janzavrel/Tensegrity_Based_Joionts/README.md

# Tensegrity_Based_Joionts
Stiffness Analysis of the Tensegrity Based Joints Compared to the Traditional Ones
