janzavrel/Tensegrity_Based_Joionts/03_winding_trajectory/models/tensegrity_revolute_joint_fixed_bottom_modif_AI.png

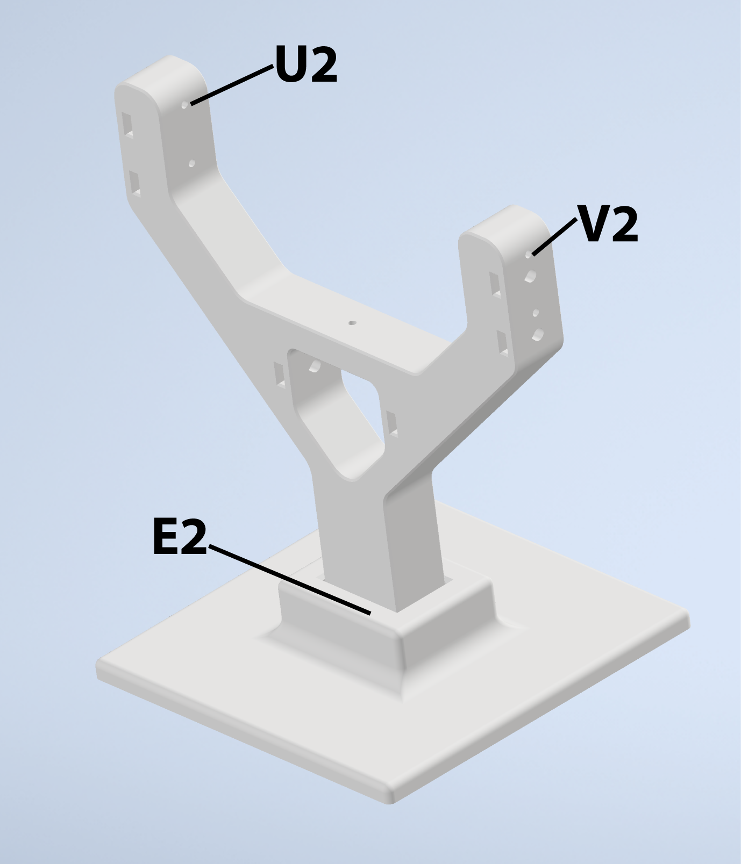
03_winding_trajectory/models/tensegrity_revolute_joint_fixed_bottom_modif_AI.png
