janzavrel/Tensegrity_Based_Joionts/03_winding_trajectory/models/tensegrity_revolute_joint_fixed_top_modif.png

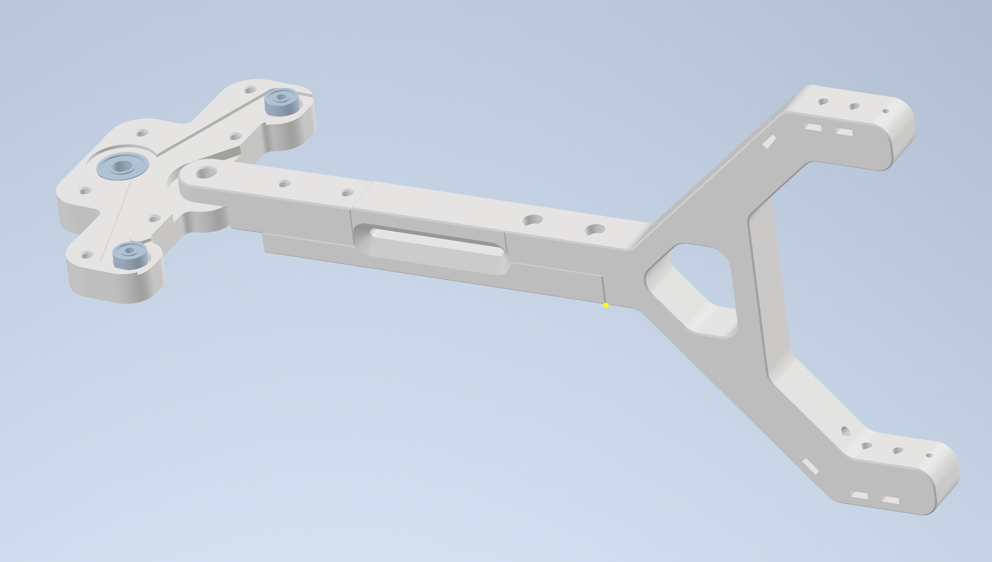
03_winding_trajectory/models/tensegrity_revolute_joint_fixed_top_modif.png
