janzavrel/Tensegrity_Based_Joionts/04_tensegrity_3D_Valasek_like/models/base_frame_3.png

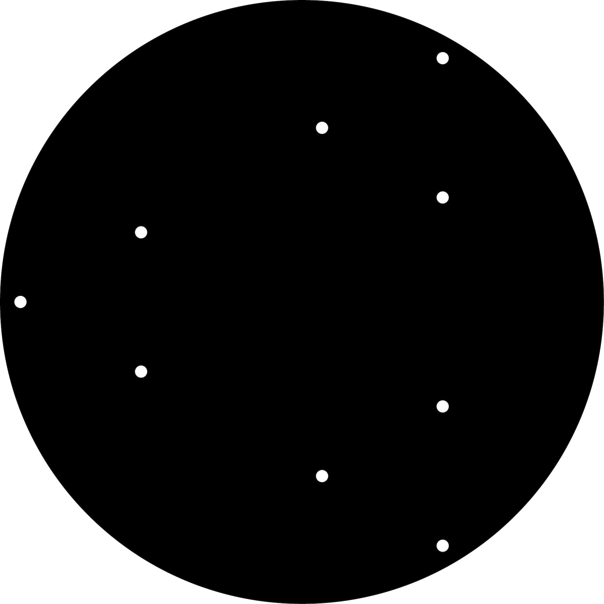
04_tensegrity_3D_Valasek_like/models/base_frame_3.png
