janzavrel/Tensegrity_Based_Joionts/05_tensegrity_joint_universal/Workspace_z_E3_x_y_z.png

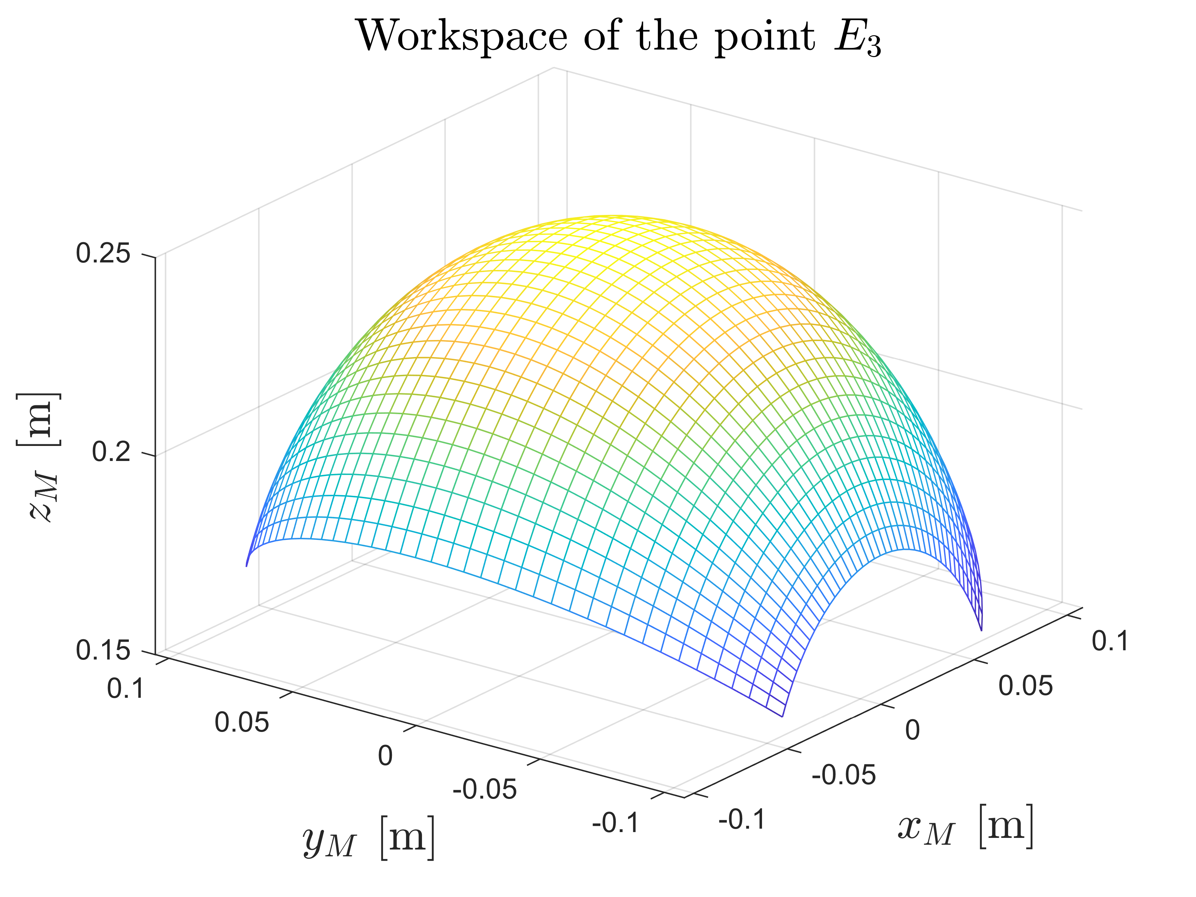
05_tensegrity_joint_universal/Workspace_z_E3_x_y_z.png
