janzavrel/Tensegrity_Based_Joionts/06_tensegrity_joint_revolute/revolute_joint_stiffnes_X.png

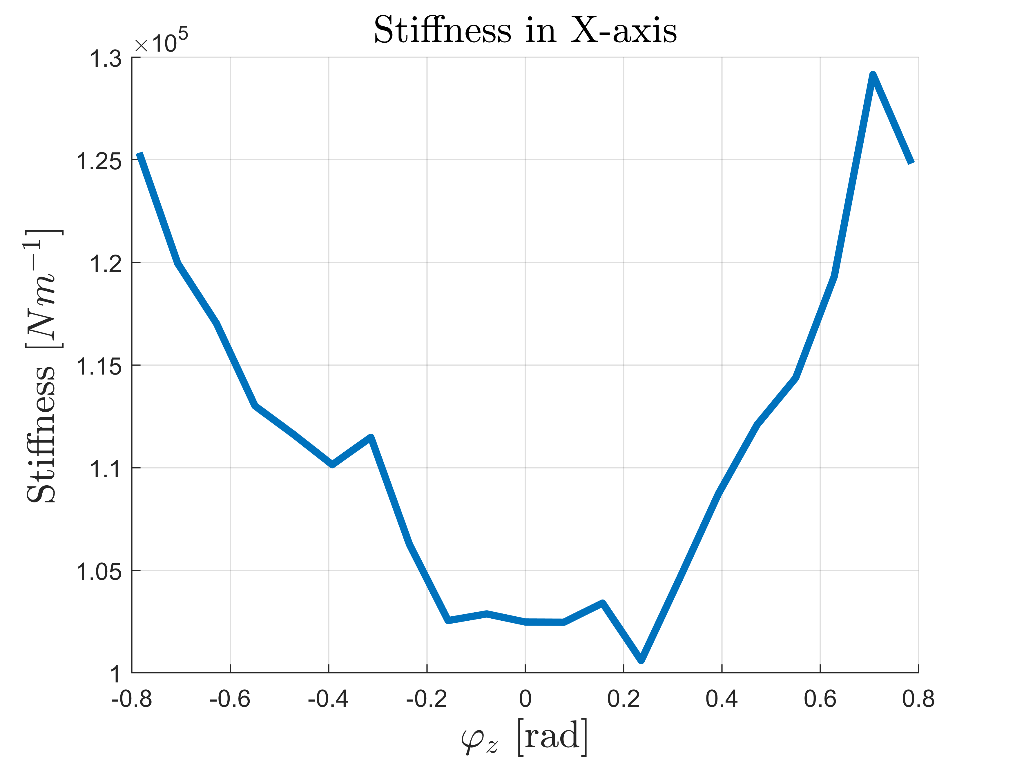
06_tensegrity_joint_revolute/revolute_joint_stiffnes_X.png
