janzavrel/Tensegrity_Based_Joionts/_foto/20231113_165553.jpg

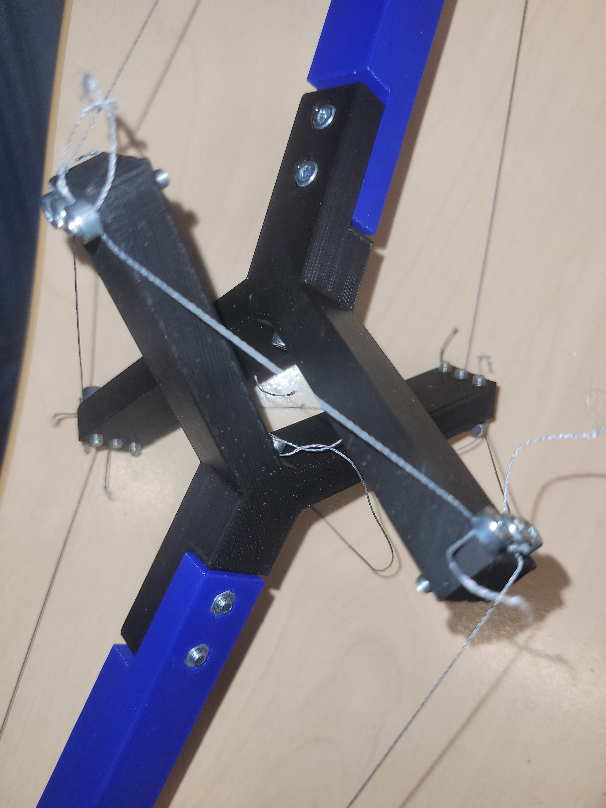
_foto/20231113_165553.jpg
