janzavrel/Tensegrity_Based_Joionts/_foto/20231231_082029.jpg

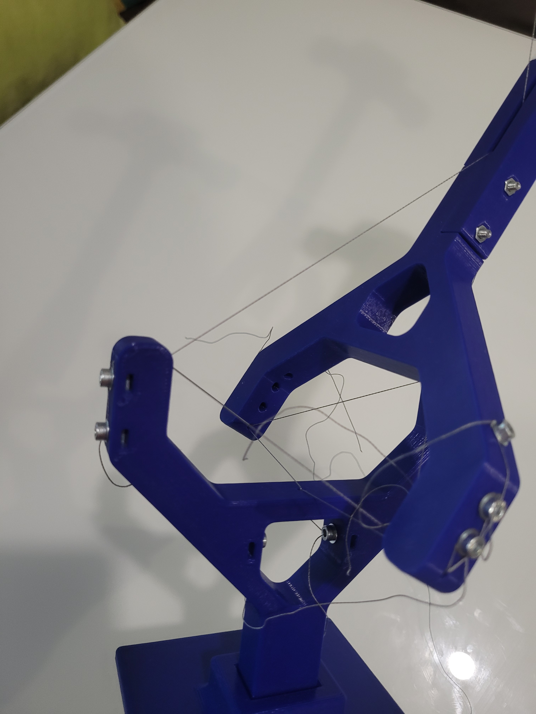
_foto/20231231_082029.jpg
