janzavrel/Tensegrity_Based_Joionts/_foto/20231231_082040.jpg

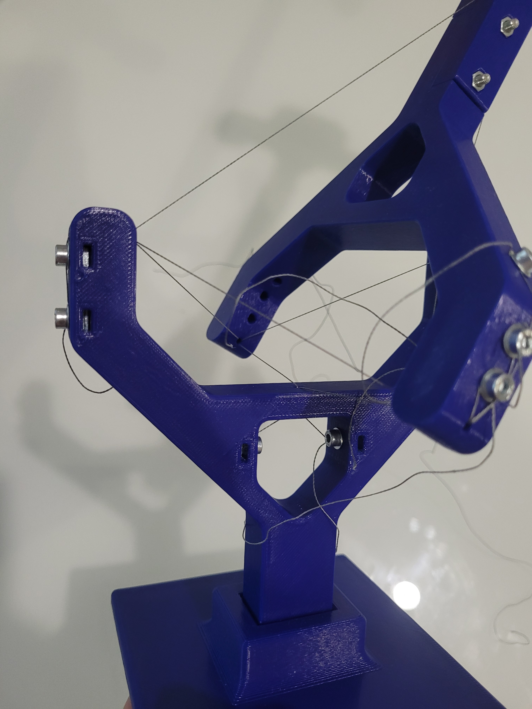
_foto/20231231_082040.jpg
