janzavrel/Tensegrity_Based_Joionts/_foto/20231231_082041.jpg

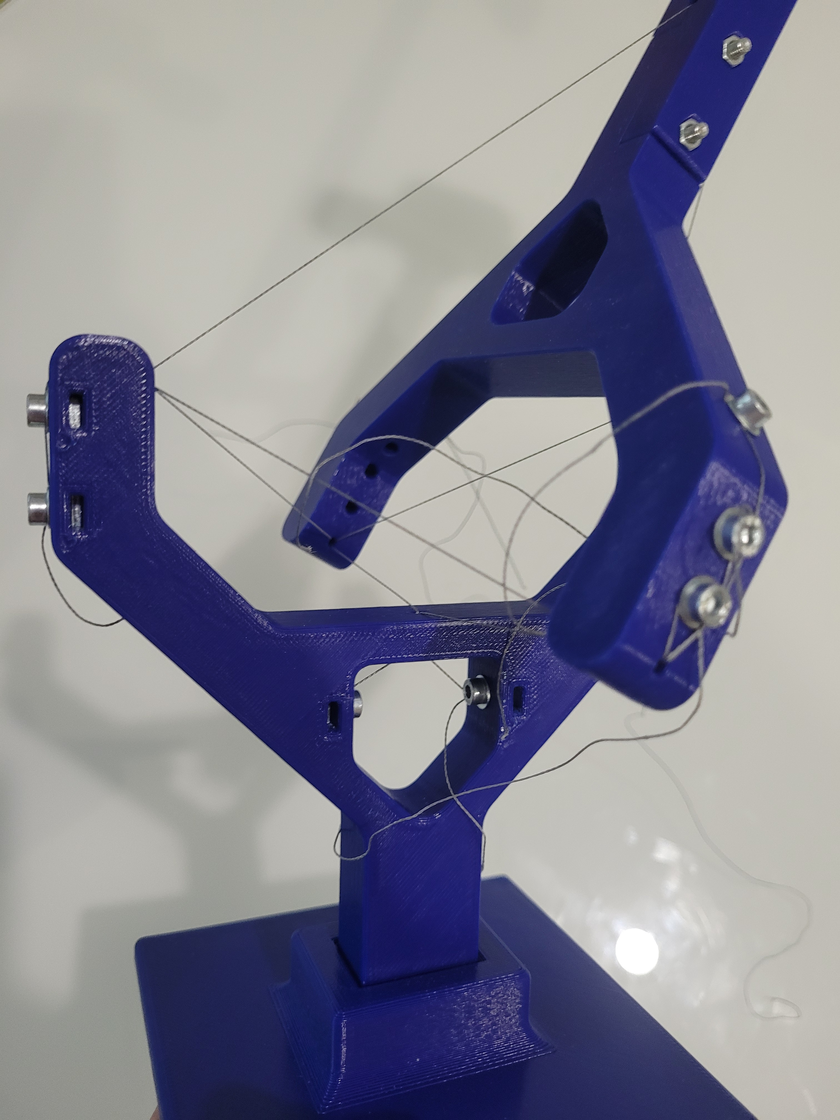
_foto/20231231_082041.jpg
