janzavrel/Tensegrity_Based_Joionts/_foto/20231231_082046.jpg

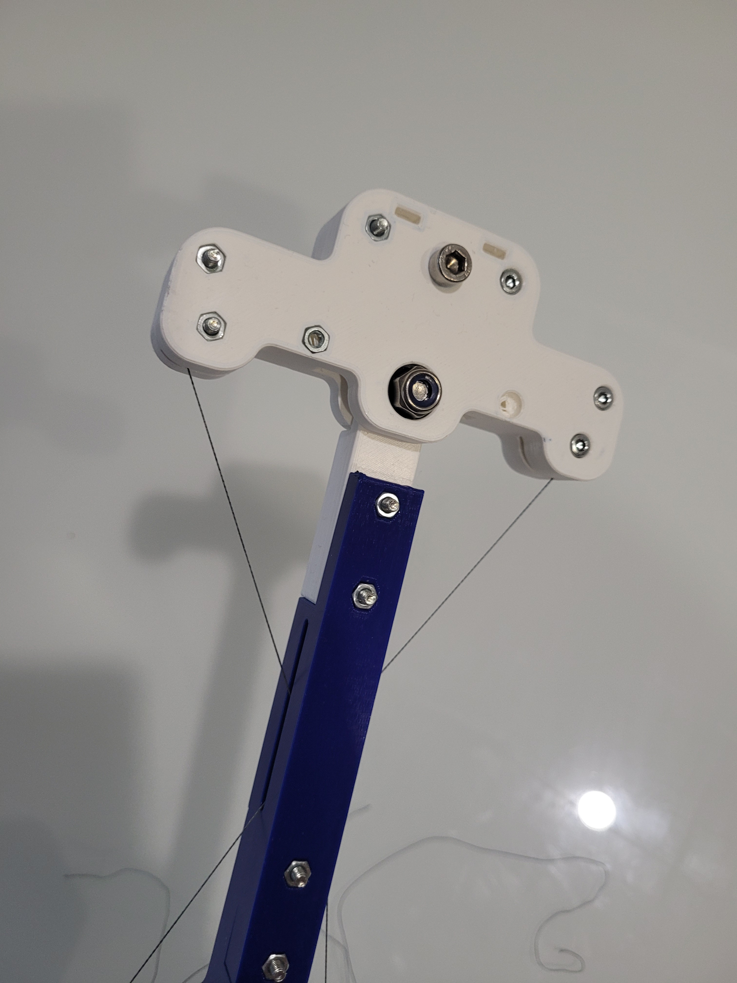
_foto/20231231_082046.jpg
