janzavrel/Tensegrity_Based_Joionts/_foto/20231231_082204.jpg

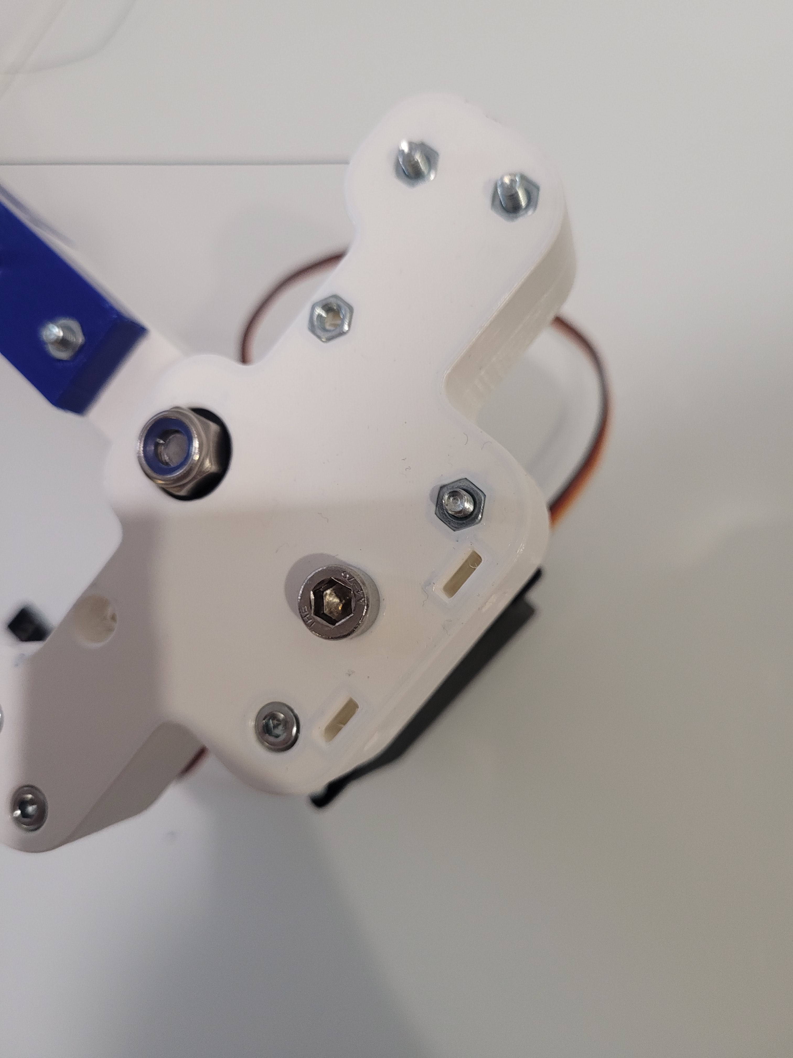
_foto/20231231_082204.jpg
