janzavrel/Tensegrity_Based_Joionts/_foto/20231231_084615.jpg

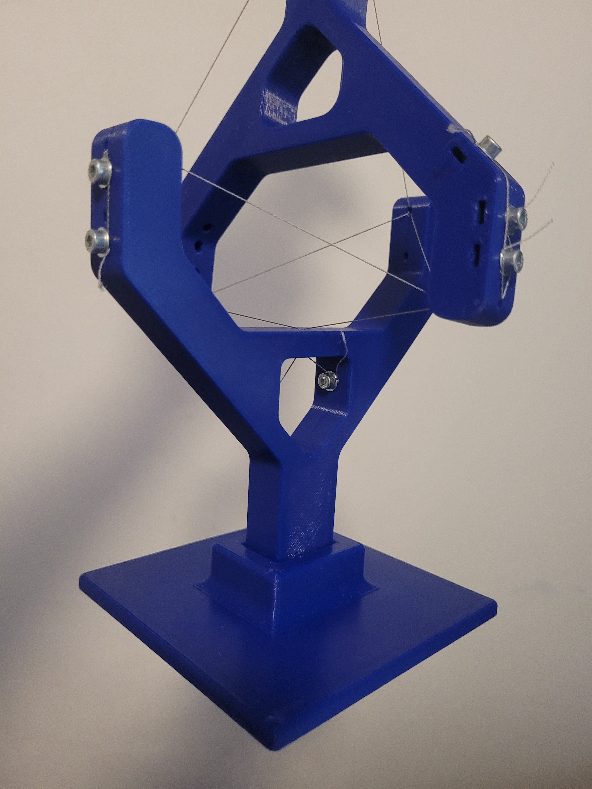
_foto/20231231_084615.jpg
