janzavrel/Tensegrity_Based_Joionts/_kontroly_GVU/zadavaci_podminky/image002.png

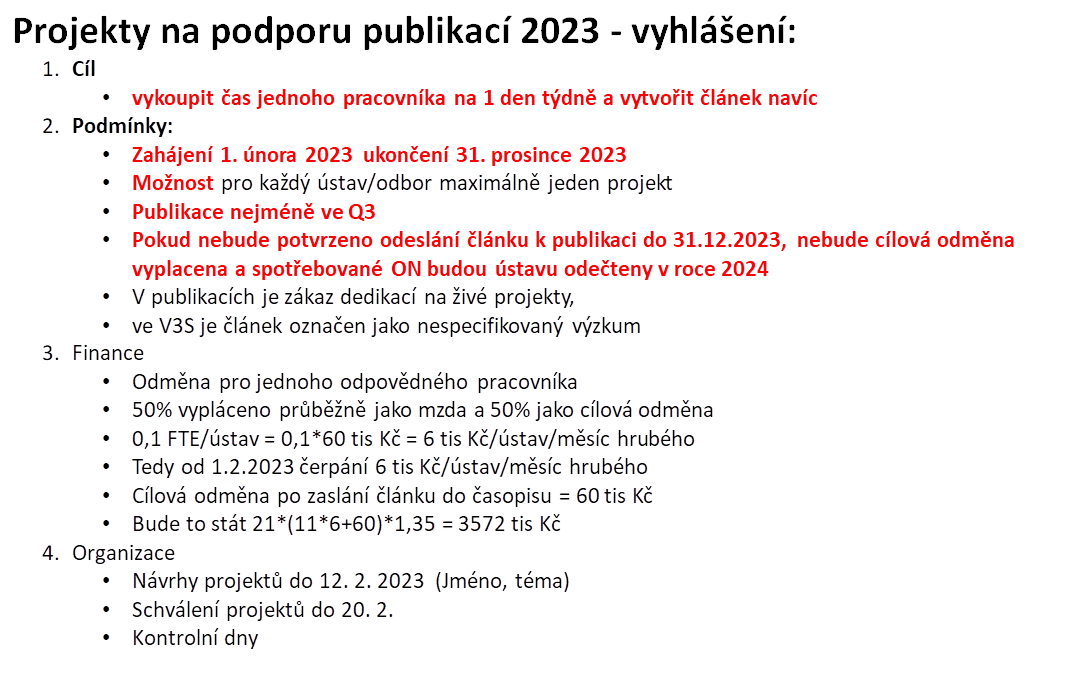
_kontroly_GVU/zadavaci_podminky/image002.png
