janzavrel/Tensegrity_Based_Joionts/03_winding_trajectory/models/3D_print/middle_hole_joint.3mf

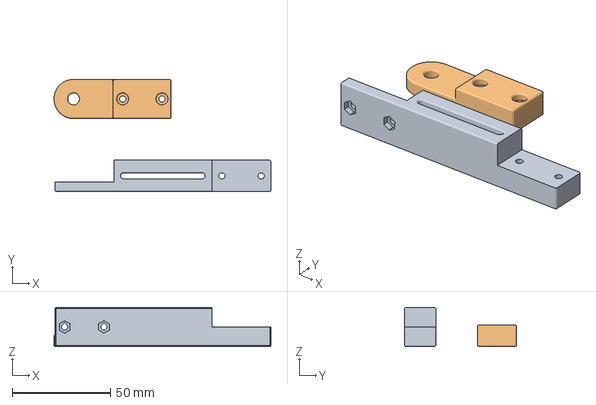
[picture p38: CAD file, 2023-11-21]
03_winding_trajectory/models/3D_print/middle_hole_joint.3mf
110.4 x 57.1 x 20.0 mm
middle_hole.stl
middle_joint.stl
