janzavrel/Tensegrity_Based_Joionts/03_winding_trajectory/models/middle_hole_v2.stl

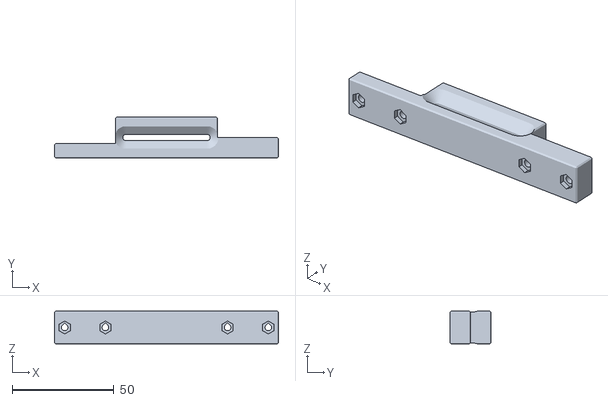
[picture p39: CAD file, 2023-11-23]
03_winding_trajectory/models/middle_hole_v2.stl
110.0 x 20.0 x 16.0
