janzavrel/Tensegrity_Based_Joionts/_modely/model_B1/B1_base.stl

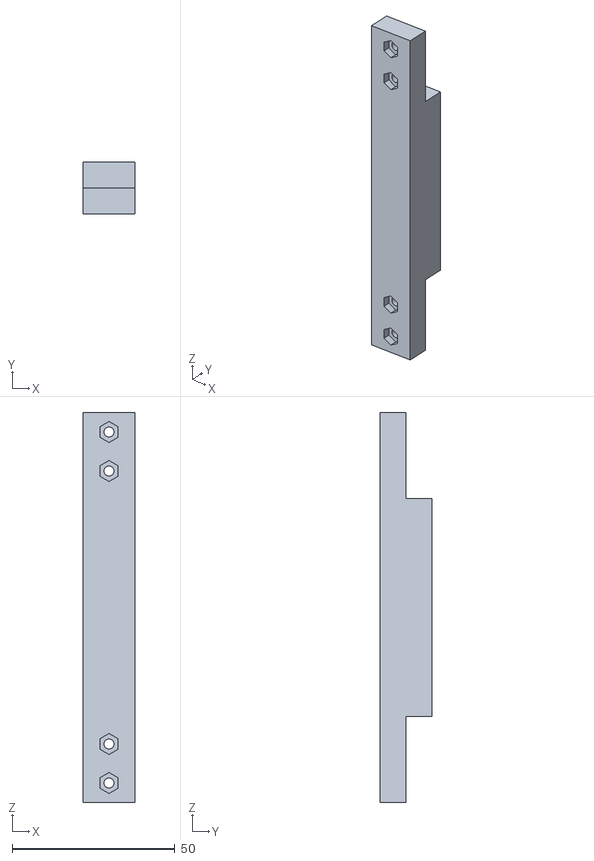
[picture p40: CAD file, 2023-06-26]
_modely/model_B1/B1_base.stl
16.0 x 16.0 x 120.0
