janzavrel/Tensegrity_Based_Joionts/03_winding_trajectory/models/3D_print/middle_joint.stl

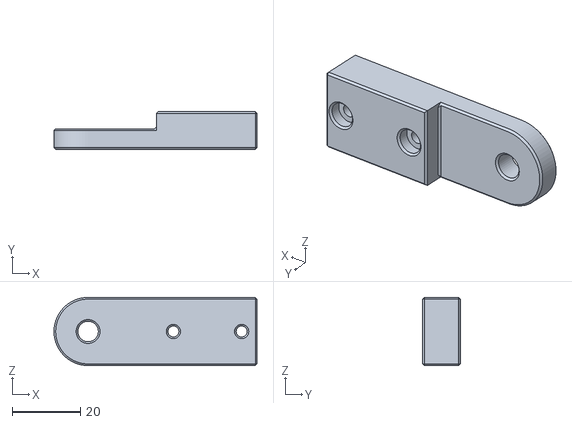
[picture p41: CAD file, 2023-11-21]
03_winding_trajectory/models/3D_print/middle_joint.stl
59.5 x 11.0 x 20.0
