janzavrel/Tensegrity_Based_Joionts/03_winding_trajectory/models/middle_joint_static.3mf

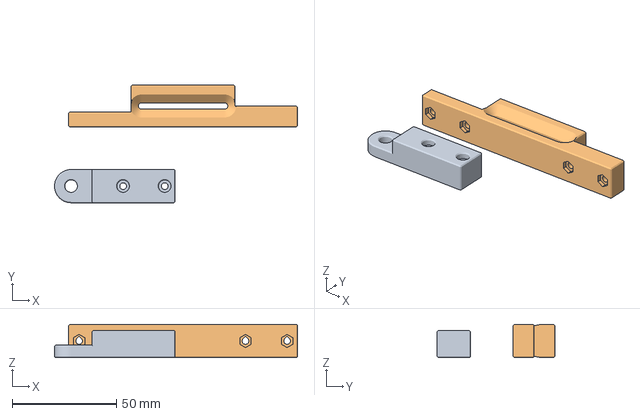
[picture p42: CAD file, 2023-11-23]
03_winding_trajectory/models/middle_joint_static.3mf
116.8 x 56.5 x 16.0 mm
middle_joint_static.stl
middle_hole_v2.stl
