janzavrel/Tensegrity_Based_Joionts/04_tensegrity_3D_Valasek_like/models/base_frame_3.stp

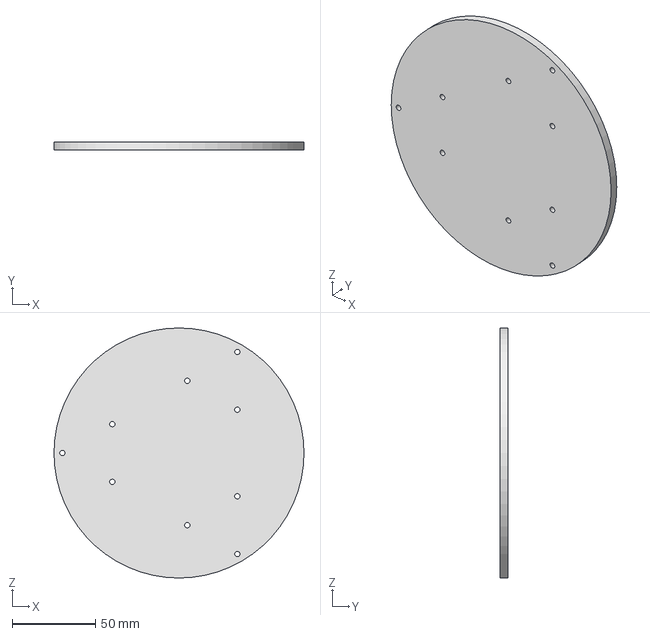
[picture p43: CAD file, 2023-11-14]
04_tensegrity_3D_Valasek_like/models/base_frame_3.stp
150.0 x 5.00 x 150.0 mm
