janzavrel/Tensegrity_Based_Joionts/_modely/model_B1/kloub_B1_components.3mf

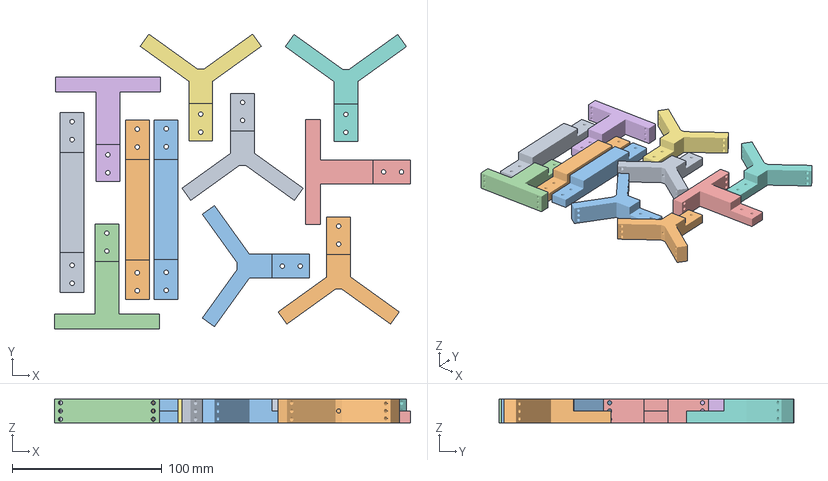
[picture p44: CAD file, 2023-06-26]
_modely/model_B1/kloub_B1_components.3mf
237.9 x 196.9 x 16.0 mm
B1_base.stl
B1_head_T.stl
B1_head_Y.stl
