janzavrel/Tensegrity_Based_Joionts/03_winding_trajectory/models/3D_print/middle_Y.3mf

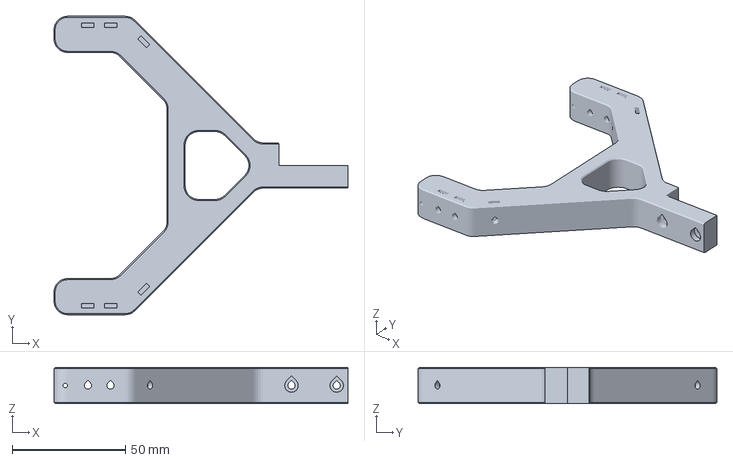
[picture p45: CAD file, 2023-11-21]
03_winding_trajectory/models/3D_print/middle_Y.3mf
130.0 x 132.0 x 16.0 mm
