janzavrel/Tensegrity_Based_Joionts/03_winding_trajectory/models/distancni_krouzek_loziska_top.stl

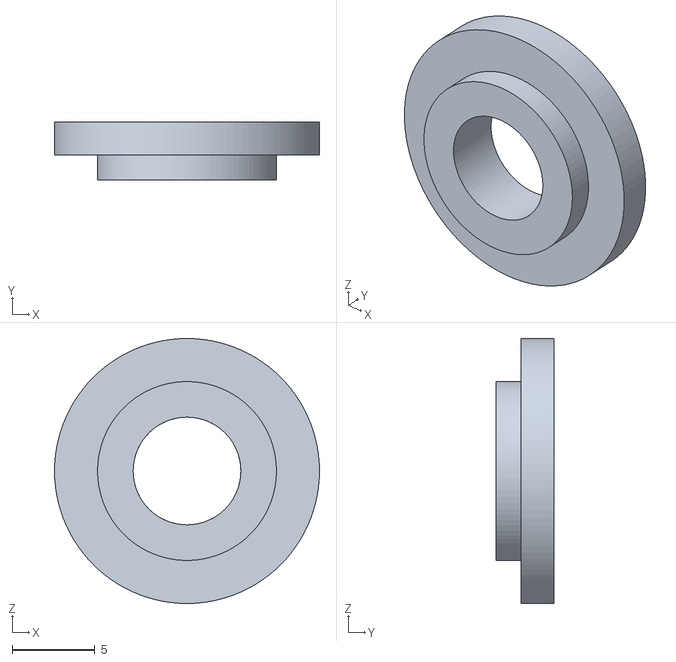
[picture p46: CAD file, 2023-11-23]
03_winding_trajectory/models/distancni_krouzek_loziska_top.stl
16.0 x 3.50 x 16.0
