janzavrel/Tensegrity_Based_Joionts/04_tensegrity_3D_Valasek_like/models/tensegrity_bar_4c_80_mm_3x.3mf

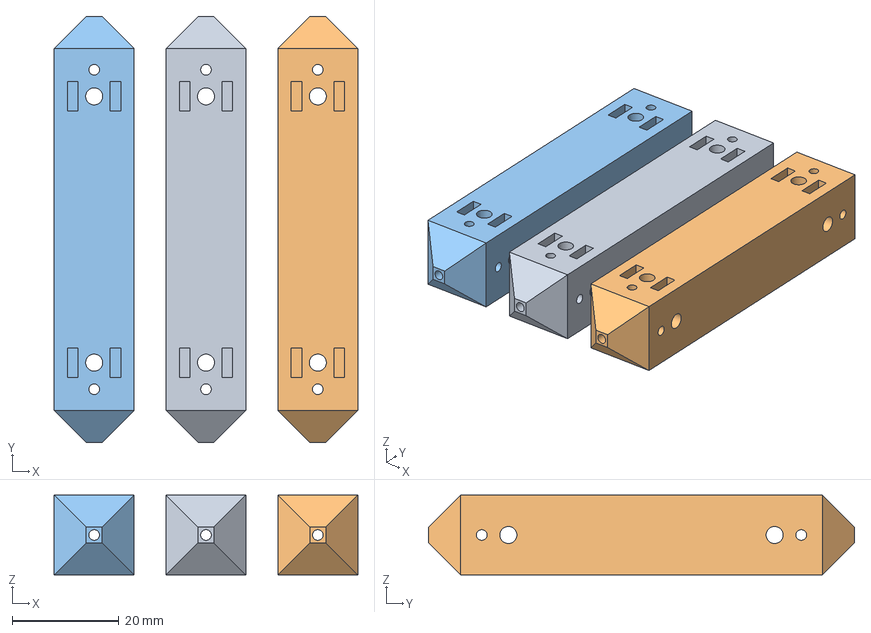
[picture p47: CAD file, 2023-11-13]
04_tensegrity_3D_Valasek_like/models/tensegrity_bar_4c_80_mm_3x.3mf
57.0 x 80.0 x 15.0 mm
