janzavrel/Tensegrity_Based_Joionts/_modely/model_B1/B1_head_Y.stl

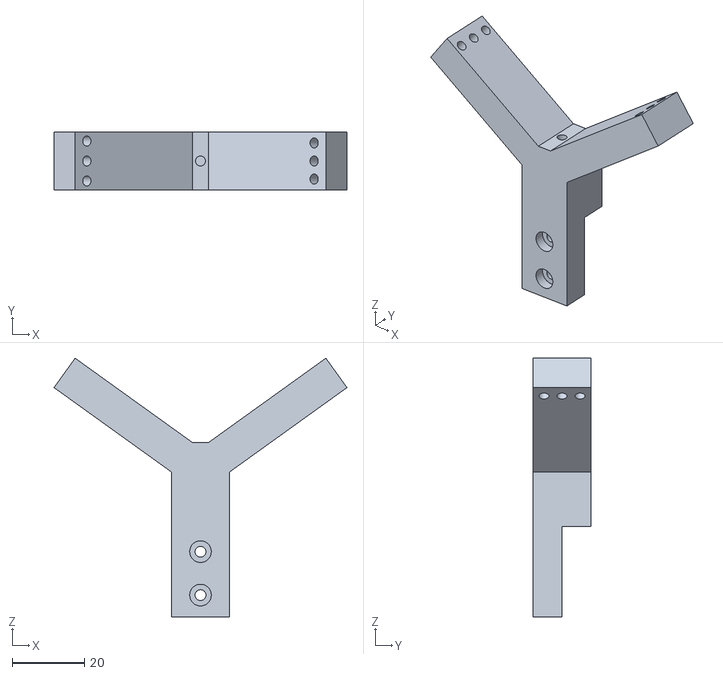
[picture p48: CAD file, 2023-06-26]
_modely/model_B1/B1_head_Y.stl
81.0 x 16.0 x 71.5
