janzavrel/Tensegrity_Based_Joionts/03_winding_trajectory/models/3D_print/middle_hole.stl

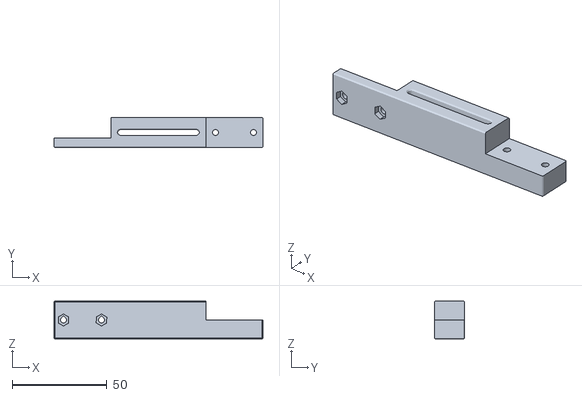
[picture p49: CAD file, 2023-11-21]
03_winding_trajectory/models/3D_print/middle_hole.stl
110.0 x 16.0 x 20.0
