janzavrel/Tensegrity_Based_Joionts/03_winding_trajectory/models/top_v2_2x.3mf

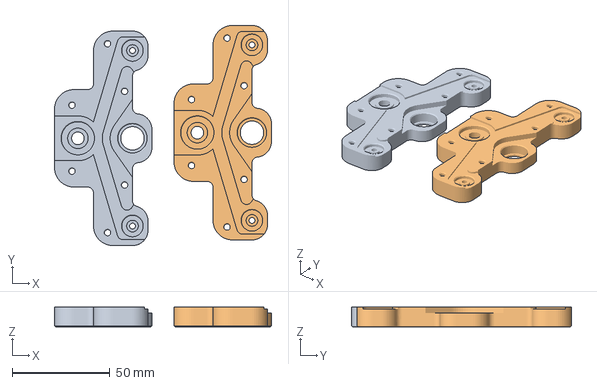
[picture p50: CAD file, 2023-11-23]
03_winding_trajectory/models/top_v2_2x.3mf
111.3 x 112.9 x 10.0 mm
