janzavrel/Tensegrity_Based_Joionts/04_tensegrity_3D_Valasek_like/models/tensegrity_bar_4c_3x.3mf

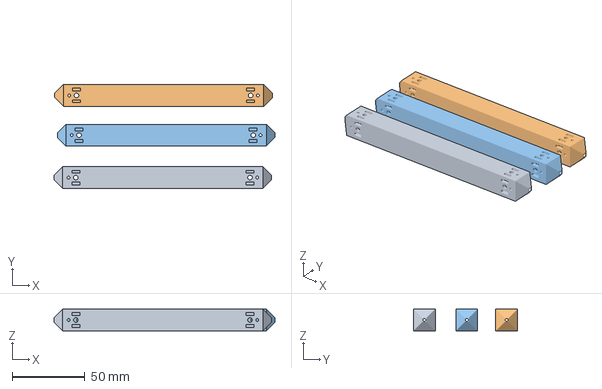
[picture p51: CAD file, 2023-11-13]
04_tensegrity_3D_Valasek_like/models/tensegrity_bar_4c_3x.3mf
152.2 x 71.6 x 15.0 mm
