janzavrel/Tensegrity_Based_Joionts/_modely/model_B1/B1_head_T_twist.3mf

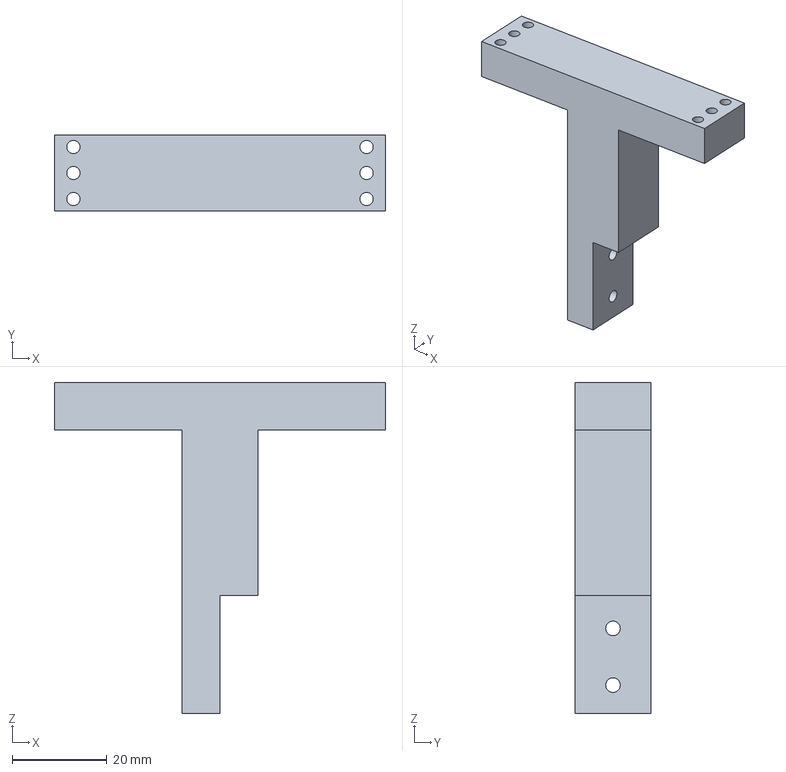
[picture p52: CAD file, 2023-06-26]
_modely/model_B1/B1_head_T_twist.3mf
70.0 x 16.0 x 70.0 mm
