janzavrel/Tensegrity_Based_Joionts/03_winding_trajectory/models/3D_print/bottom.3mf

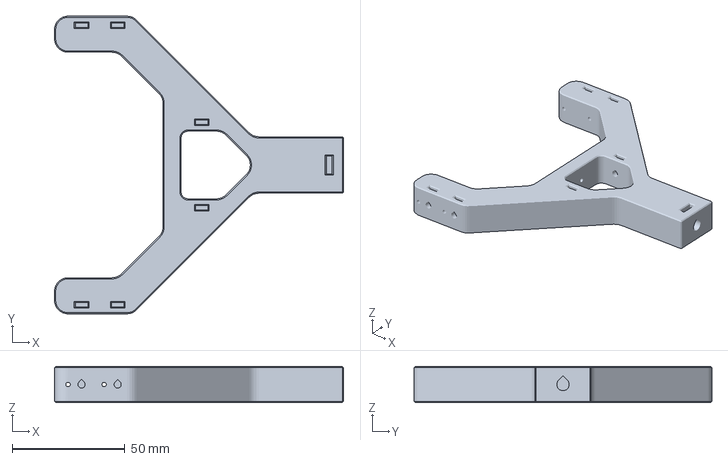
[picture p53: CAD file, 2023-11-15]
03_winding_trajectory/models/3D_print/bottom.3mf
128.1 x 132.0 x 16.0 mm
