janzavrel/Tensegrity_Based_Joionts/03_winding_trajectory/models/mid_joint_AND_hole.3mf

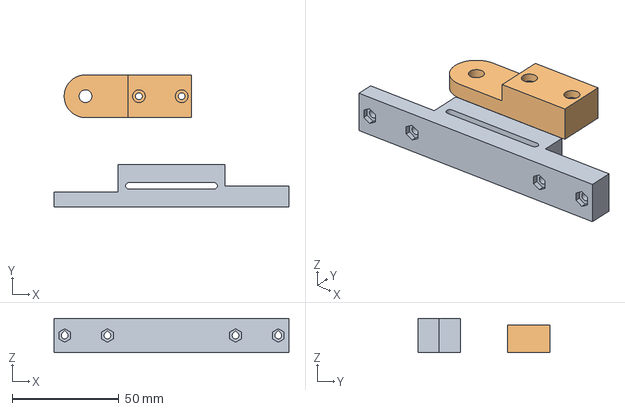
[picture p54: CAD file, 2023-11-23]
03_winding_trajectory/models/mid_joint_AND_hole.3mf
110.0 x 61.9 x 16.0 mm
middle_hole_v2.stl
middle_joint_v2.stl
