janzavrel/Tensegrity_Based_Joionts/04_tensegrity_3D_Valasek_like/models/tensegrity_bar_4c_9x.3mf

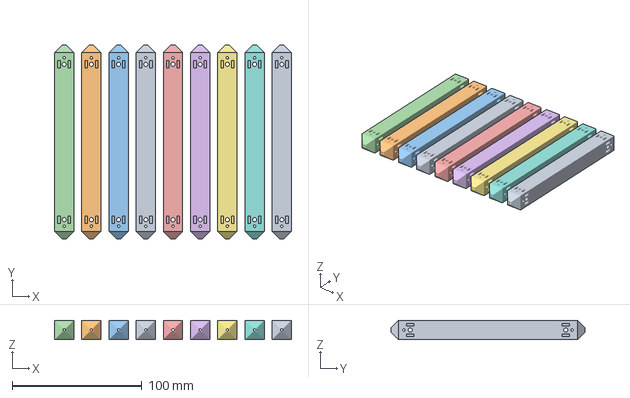
[picture p55: CAD file, 2023-11-13]
04_tensegrity_3D_Valasek_like/models/tensegrity_bar_4c_9x.3mf
183.0 x 150.0 x 15.0 mm
