janzavrel/Tensegrity_Based_Joionts/03_winding_trajectory/models/kladicka.3mf

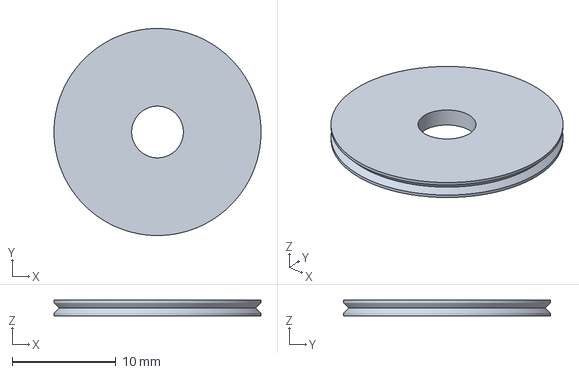
[picture p56: CAD file, 2023-11-23]
03_winding_trajectory/models/kladicka.3mf
20.0 x 20.0 x 1.50 mm
