janzavrel/Tensegrity_Based_Joionts/04_tensegrity_3D_Valasek_like/models/tensegrity_bar_4c.3mf

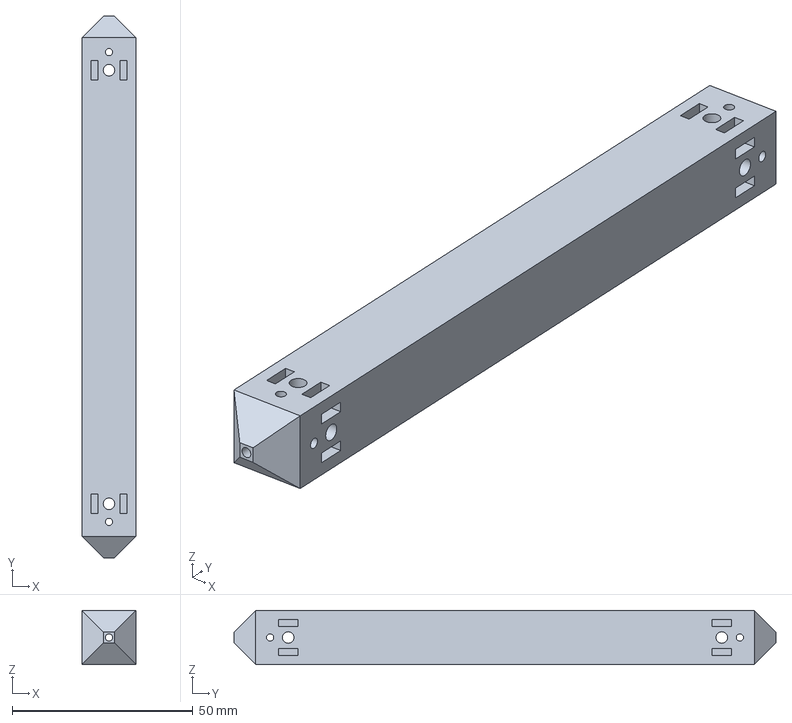
[picture p57: CAD file, 2023-11-13]
04_tensegrity_3D_Valasek_like/models/tensegrity_bar_4c.3mf
15.0 x 150.0 x 15.0 mm
