janzavrel/Tensegrity_Based_Joionts/03_winding_trajectory/models/top_v2.stl

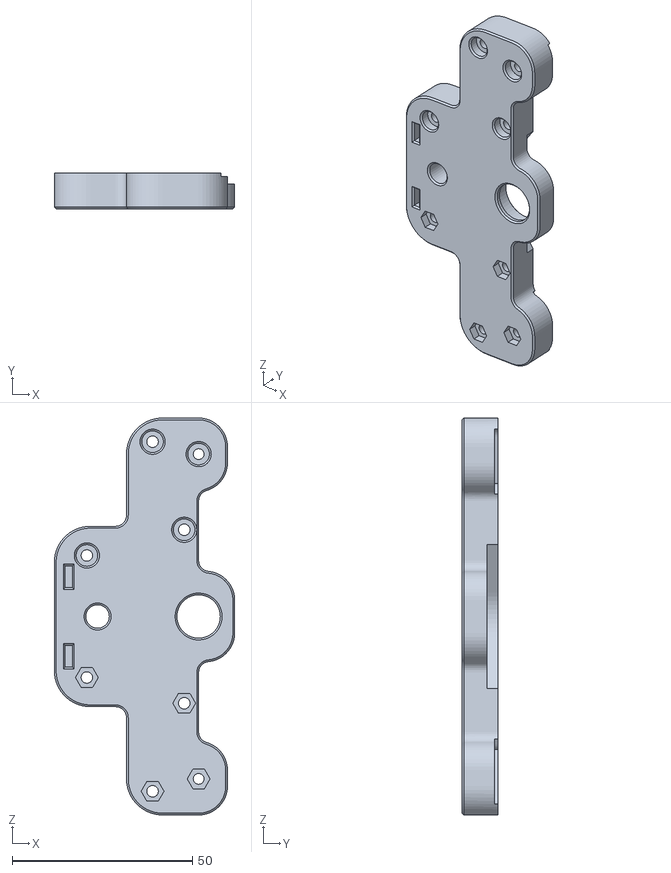
[picture p58: CAD file, 2023-11-23]
03_winding_trajectory/models/top_v2.stl
50.0 x 10.0 x 110.0
