janzavrel/Tensegrity_Based_Joionts/04_tensegrity_3D_Valasek_like/models/tensegrity_bar_4c_2base_frame.stl

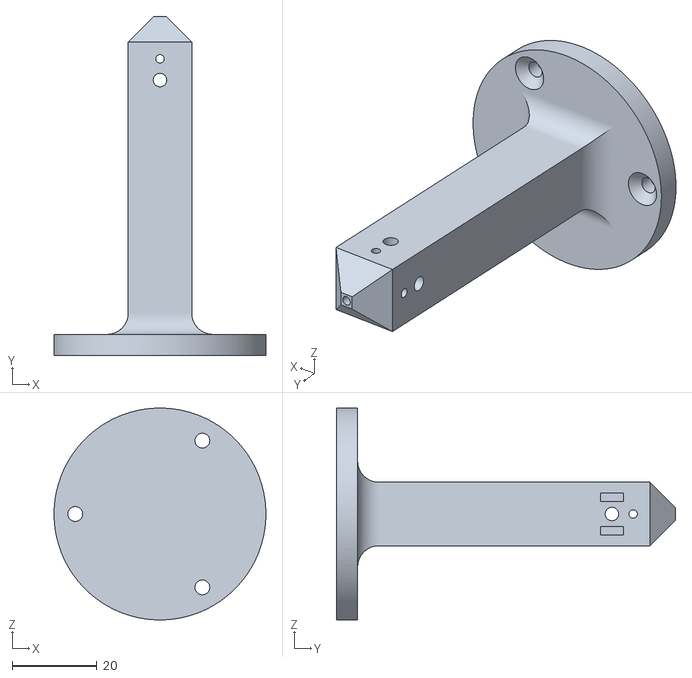
[picture p59: CAD file, 2023-11-13]
04_tensegrity_3D_Valasek_like/models/tensegrity_bar_4c_2base_frame.stl
50.0 x 80.0 x 50.0
