janzavrel/Tensegrity_Based_Joionts/03_winding_trajectory/models/middle_joint_v2.stl

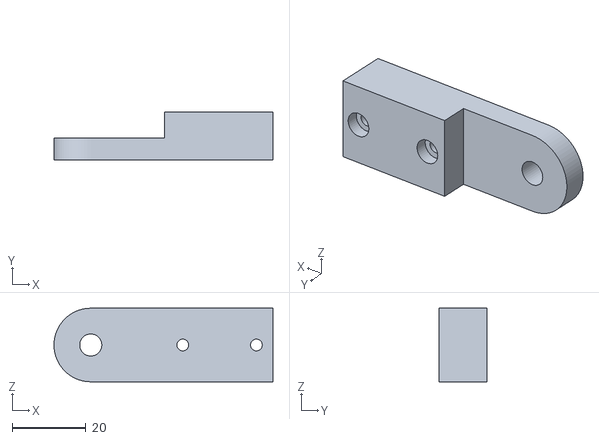
[picture p60: CAD file, 2023-11-23]
03_winding_trajectory/models/middle_joint_v2.stl
59.5 x 13.0 x 20.0
