janzavrel/Tensegrity_Based_Joionts/04_tensegrity_3D_Valasek_like/models/tensegrity_bar_4c_2base_frame_3x.3mf

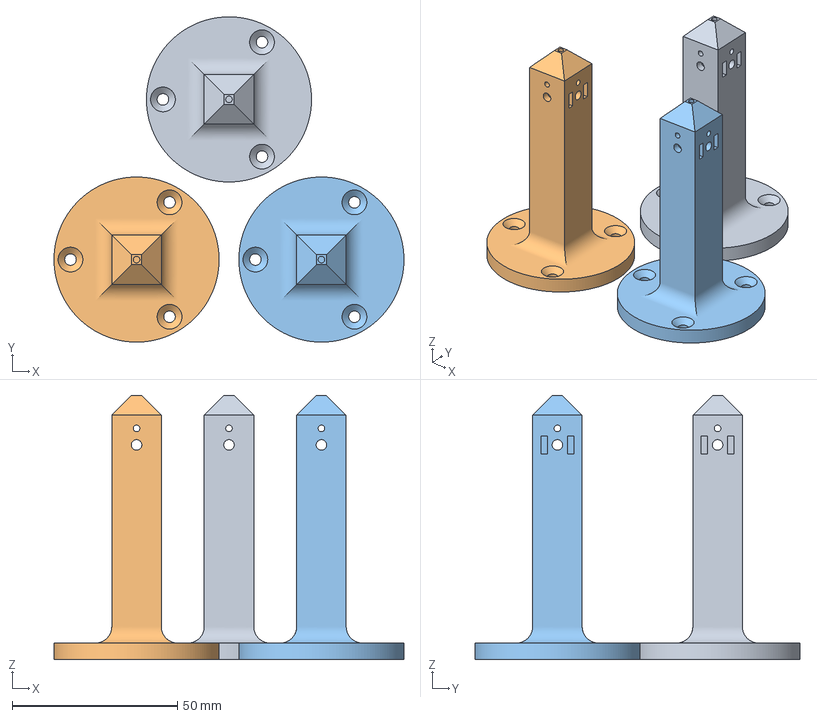
[picture p61: CAD file, 2023-11-13]
04_tensegrity_3D_Valasek_like/models/tensegrity_bar_4c_2base_frame_3x.3mf
106.0 x 98.5 x 80.0 mm
