janzavrel/Tensegrity_Based_Joionts/03_winding_trajectory/models/base_frame.3mf

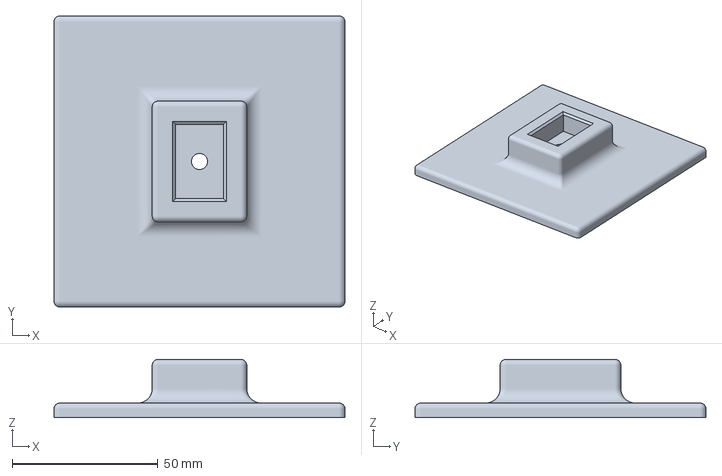
[picture p63: CAD file, 2023-11-20]
03_winding_trajectory/models/base_frame.3mf
100.0 x 100.0 x 20.0 mm
