janzavrel/Tensegrity_Based_Joionts/(list of files, cad)

Other CAD files:
04_tensegrity_3D_Valasek_like/models/LASER.dwg
_modely/model_B1/B1_head_T.stl
03_winding_trajectory/models/3D_print/bottom.stl
03_winding_trajectory/models/3D_print/middle_Y.stl
03_winding_trajectory/models/OldVersions/base_frame.0001.ipt
03_winding_trajectory/models/OldVersions/base_frame_3.0001.ipt
03_winding_trajectory/models/OldVersions/bearing_d3D10b4.0002.ipt
03_winding_trajectory/models/OldVersions/bearing_d6D15b5.0002.ipt
03_winding_trajectory/models/OldVersions/bottom.0003.ipt
03_winding_trajectory/models/OldVersions/kladicka.0001.ipt
03_winding_trajectory/models/OldVersions/middle_Y.0008.ipt
03_winding_trajectory/models/OldVersions/middle_hole.0006.ipt
03_winding_trajectory/models/OldVersions/middle_hole_v2.0009.ipt
03_winding_trajectory/models/OldVersions/middle_joint.0004.ipt
03_winding_trajectory/models/OldVersions/middle_joint_static.0008.ipt
03_winding_trajectory/models/OldVersions/middle_joint_v2.0007.ipt
03_winding_trajectory/models/OldVersions/tensegrity_revolute_joint.0003.iam
03_winding_trajectory/models/OldVersions/tensegrity_revolute_joint_fixed.0001.iam
03_winding_trajectory/models/OldVersions/top.0004.ipt
03_winding_trajectory/models/OldVersions/top_v2.0006.ipt
03_winding_trajectory/models/base_frame.ipt
03_winding_trajectory/models/base_frame.stl
03_winding_trajectory/models/bearing_d3D10b4.ipt
03_winding_trajectory/models/bearing_d6D15b5.ipt
03_winding_trajectory/models/bottom.ipt
03_winding_trajectory/models/bottom.stl
03_winding_trajectory/models/distance_ring_cable_bearing.ipt
03_winding_trajectory/models/distancni_krouzek_loziska_top.ipt
03_winding_trajectory/models/kladicka.ipt
03_winding_trajectory/models/kladicka.stl
03_winding_trajectory/models/middle_Y.ipt
03_winding_trajectory/models/middle_hole.ipt
03_winding_trajectory/models/middle_hole_v2.ipt
03_winding_trajectory/models/middle_joint.ipt
03_winding_trajectory/models/middle_joint_static.ipt
03_winding_trajectory/models/middle_joint_static.stl
03_winding_trajectory/models/middle_joint_v2.ipt
03_winding_trajectory/models/tensegrity_revolute_joint.iam
03_winding_trajectory/models/tensegrity_revolute_joint_fixed.iam
03_winding_trajectory/models/top.ipt
03_winding_trajectory/models/top.stl
03_winding_trajectory/models/top_2x.3mf
03_winding_trajectory/models/top_v2.ipt
04_tensegrity_3D_Valasek_like/models/OldVersions/base_frame_3.0001.dwg
04_tensegrity_3D_Valasek_like/models/OldVersions/base_frame_3.0001_1.dwg
04_tensegrity_3D_Valasek_like/models/OldVersions/tensegrity_bar_4c.0001.ipt
04_tensegrity_3D_Valasek_like/models/OldVersions/tensegrity_bar_4c_2base_frame.0001.ipt
04_tensegrity_3D_Valasek_like/models/OldVersions/tensegrity_bar_4c_80_mm.0001.ipt
04_tensegrity_3D_Valasek_like/models/base_frame_3.dwg
04_tensegrity_3D_Valasek_like/models/base_frame_3.idw
04_tensegrity_3D_Valasek_like/models/base_frame_3.ipt
04_tensegrity_3D_Valasek_like/models/tensegrity_bar_4c.ipt
04_tensegrity_3D_Valasek_like/models/tensegrity_bar_4c.stl
04_tensegrity_3D_Valasek_like/models/tensegrity_bar_4c_2base_frame.ipt
04_tensegrity_3D_Valasek_like/models/tensegrity_bar_4c_80_mm.ipt
_modely/model_B1/B1_base.ipt
_modely/model_B1/B1_head_T.ipt
_modely/model_B1/B1_head_T_twist.ipt
_modely/model_B1/B1_head_T_twist.stl
_modely/model_B1/B1_head_Y.ipt
_modely/model_B1/OldVersions/B1_base.0004.ipt
_modely/model_B1/OldVersions/B1_head_T.0002.ipt
_modely/model_B1/OldVersions/B1_head_T_twist.0004.ipt
