janzavrel/Tensegrity_Based_Joionts/(commit log)

2023-03-27 A recherche folder for joint stiffness added
2023-03-31 * The recherche part for joint stiffness identification added * The documentation extended
2023-04-20 simple joint A started
2023-06-14 Model of the B1 joint started.
    [B1_base.0004.ipt, B1_base.ipt, B1_head_T.ipt]
2023-06-26 3D model of the B1 joint
    [B1_base.stl, B1_head_T.0002.ipt, B1_head_T.ipt, B1_head_T.stl, B1_head_T_twist.0004.ipt, B1_head_T_twist.3mf, B1_head_T_twist.ipt, B1_head_T_twist.stl]
2023-11-09 Work after months
    [B1_base.0004.ipt, B1_base.ipt, B1_base.stl, B1_head_T.0002.ipt, B1_head_T.ipt, B1_head_T.stl, B1_head_T_twist.0004.ipt, B1_head_T_twist.3mf]
2023-11-09 Synchronizing after months
    [B1_base.0004.ipt, B1_base.ipt, B1_base.stl, B1_head_T.0002.ipt, B1_head_T.ipt, B1_head_T.stl, B1_head_T_twist.0004.ipt, B1_head_T_twist.3mf]
2023-11-13 3D tensegrity like Val done, preparation of simulation
    [tensegrity_bar_4c.0001.ipt, tensegrity_bar_4c.3mf, tensegrity_bar_4c.ipt, tensegrity_bar_4c.stl, tensegrity_bar_4c_2base_frame.0001.ipt, tensegrity_bar_4c_2base_frame.ipt, tensegrity_bar_4c_2base_frame.stl, tensegrity_bar_4c_2base_frame_3x.3mf]
2023-11-13 Presentation 2023/11/16 started
    [tensegrity_bar_4c_80_mm_3x.3mf]
2023-11-14 Base frame model added
    [LASER.dwg, base_frame_3.0001.dwg, base_frame_3.0001.ipt, base_frame_3.0001_1.dwg, base_frame_3.dwg, base_frame_3.idw, base_frame_3.ipt, base_frame_3.stp]
2023-11-15 2 stage model Valasek like started
    [bottom.0001.ipt, bottom.0003.ipt, bottom.3mf, bottom.ipt, bottom.stl]
2023-11-15 Base frame modelled
    [base_frame.ipt]
2023-11-16 Top part with pulley modelled
    [base_frame.0001.ipt, base_frame.3mf, base_frame.ipt, base_frame.stl, distance_ring_cable_bearing.ipt, top.0001.ipt, top.ipt]
2023-11-20 top part finished
    [base_frame.3mf, top.0001.ipt, top.0003.ipt, top.ipt, top.stl, top_2x.3mf]
2023-11-20 Middle part all parts started
    [middle_Y.0002.ipt, middle_Y.ipt, middle_hole.0002.ipt, middle_hole.ipt, middle_hole.stl, middle_joint.0004.ipt, middle_joint.ipt, middle_joint.stl]
2023-11-21 Middle Y almost done
    [middle_Y.0002.ipt, middle_Y.0003.ipt, middle_Y.ipt, middle_hole.0002.ipt, middle_hole.0006.ipt, middle_hole.ipt]
2023-11-21 Middle Y model finished
    [middle_Y.0003.ipt, middle_Y.0008.ipt, middle_Y.3mf, middle_Y.ipt, middle_Y.stl, middle_hole.stl, middle_hole_joint.3mf, middle_joint.stl]
2023-11-21 some model parts added
    [top.0003.ipt, top.ipt]
2023-11-23 Inventor model v2 prepared
    [bearing_d3D10b4.0002.ipt, bearing_d3D10b4.ipt, bearing_d6D15b5.0002.ipt, bearing_d6D15b5.ipt, distancni_krouzek_loziska_top.ipt, distancni_krouzek_loziska_top.stl, kladicka.0001.ipt, kladicka.3mf]
2023-11-23 Fixed joint created
    [middle_hole_v2.0008.ipt, middle_hole_v2.0009.ipt, middle_hole_v2.ipt, middle_hole_v2.stl, middle_joint_static.0008.ipt, middle_joint_static.3mf, middle_joint_static.ipt, middle_joint_static.stl]
2023-12-11 Two stage tensegrity like VAL finished
2023-12-11 Two stage tensegrity finished
2023-12-13 Universal tensegrity joint started
2023-12-14 Universal joint complete, stiffness analysis added
2023-12-31 Article almost done
    [tensegrity_revolute_joint_fixed.0001.iam, tensegrity_revolute_joint_fixed.iam]
